Open-Acidification/TankController-KiCad-archive/switching_Regulator/PCBimages_1(1)/pcb_example.png

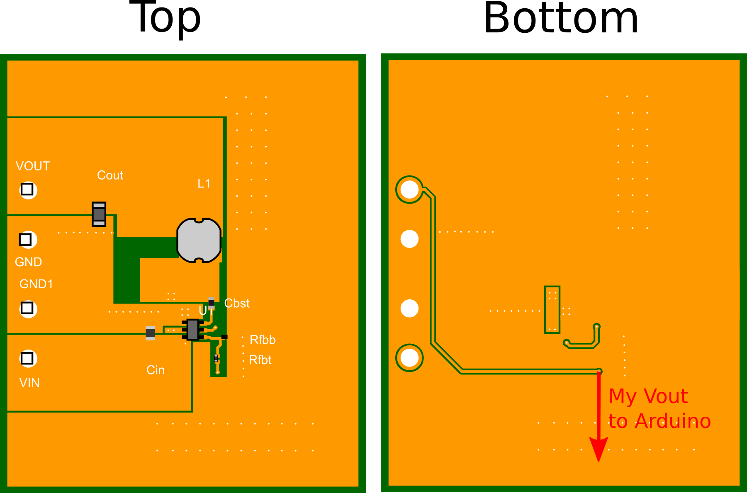
switching_Regulator/PCBimages_1(1)/pcb_example.png
