Open-Acidification/TankController-KiCad-archive/switching_Regulator/WBDesign1.svg.png

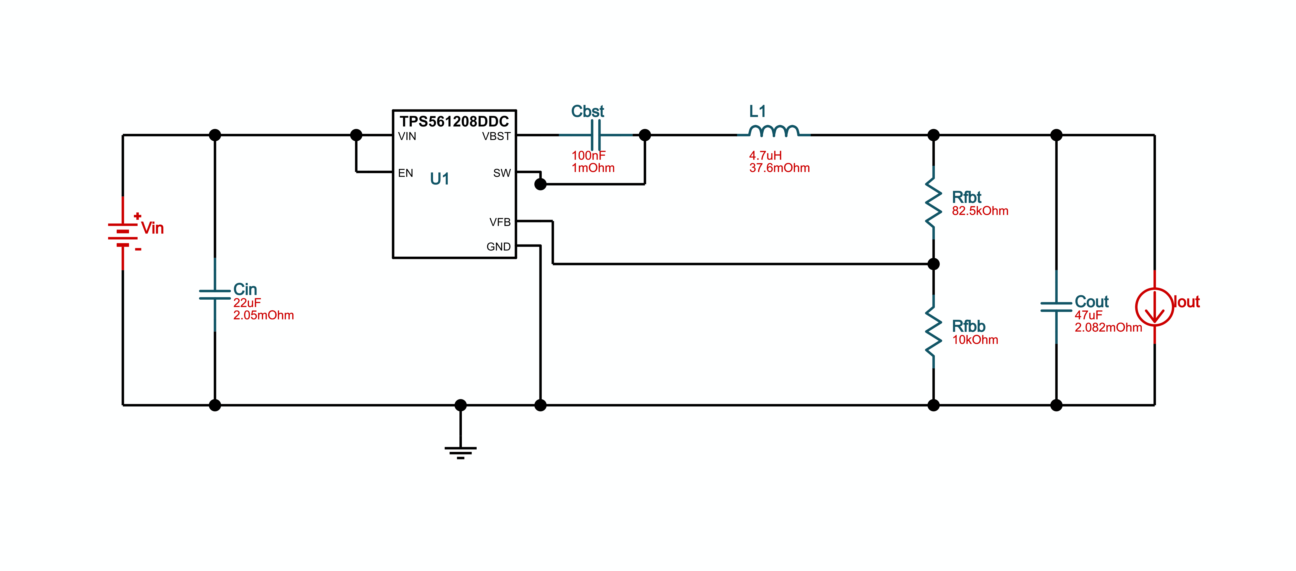
switching_Regulator/WBDesign1.svg.png
