Open-Acidification/TankController-KiCad-archive/(commit log)

2019-03-02 adding RTC and switching power supply, rewiring
    [Half_Shield.kicad_pcb, Half_Shield.sch]
2019-03-02 100k ohm resistor on EN to IN
    [Half_Shield.sch]
2019-03-11 first attempt at buck converter
    [Half_Shield.kicad_pcb, Half_Shield.sch, WBBOMDesign1.csv]
2019-03-12 buck converter second try with filled zones
    [Half_Shield.kicad_pcb]
2019-03-15 grounded switching regulator circuit and other small modifications
    [Half_Shield.kicad_pcb, Half_Shield.sch]
2019-03-18 finalizing switching regulator circuit
    [Half_Shield.kicad_pcb, Half_Shield.sch]
2019-03-19 gerber files added
    [Half_Shield-B.Cu.gbr, Half_Shield-B.Mask.gbr, Half_Shield-B.Paste.gbr, Half_Shield-B.SilkS.gbr, Half_Shield-Edge.Cuts.gbr, Half_Shield-F.Cu.gbr, Half_Shield-F.Mask.gbr, Half_Shield-F.Paste.gbr]
2019-04-03 fixing RTC placement and 0805 resistors on the switching regulator
    [Half_Shield.kicad_pcb]
2019-04-03 small fix to pcb
    [Half_Shield.kicad_pcb, Half_Shield.sch]
2019-04-06 Open Acidification Project logo
    [Half_Shield.kicad_pcb]
2019-04-06 added jumpers for alternate power
    [Half_Shield.kicad_pcb, Half_Shield.sch]
2019-04-07 gerber files made
    [Half_Shield-B.Cu.gbr, Half_Shield-B.Mask.gbr, Half_Shield-B.SilkS.gbr, Half_Shield-Edge.Cuts.gbr, Half_Shield-F.Cu.gbr, Half_Shield-F.Mask.gbr, Half_Shield-F.SilkS.gbr, Half_Shield.drl]
2019-06-08 final power jumpers
    [Half_Shield-B.Cu.gbr, Half_Shield-B.Mask.gbr, Half_Shield-B.SilkS.gbr, Half_Shield-Edge.Cuts.gbr, Half_Shield-F.Cu.gbr, Half_Shield-F.Mask.gbr, Half_Shield-F.SilkS.gbr, Half_Shield.drl]
